thermalogic/PiVisionCar/(list of files, drawings)

Other design files:
layout/driver_board.fzz
layout/linked_lines_dual_powers_simple.fzz
